jef-sure/esp32-co2-station/images/20260601_181752.jpg

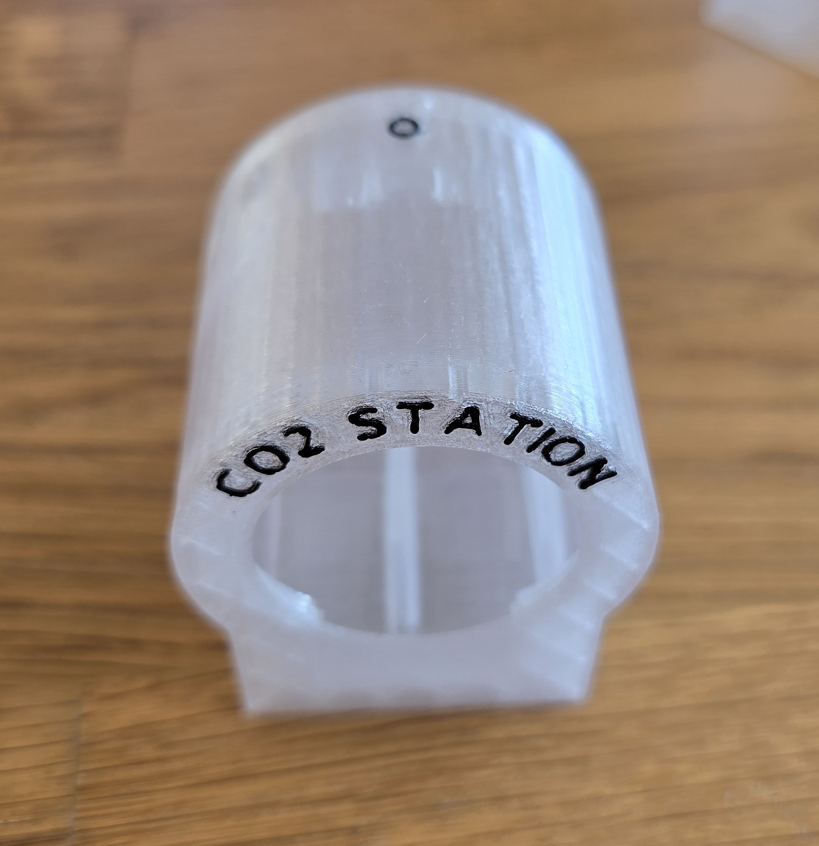
images/20260601_181752.jpg
