jef-sure/esp32-co2-station/images/20260603_193704.jpg

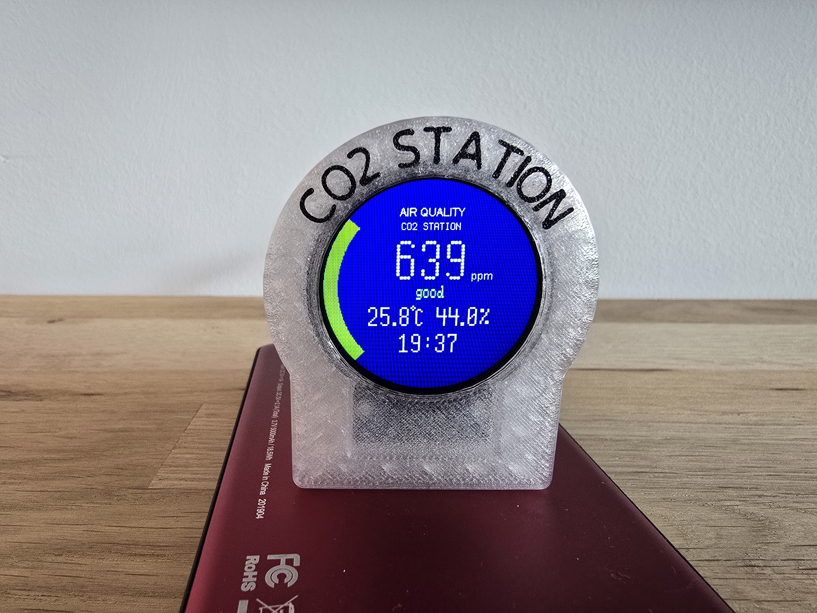
images/20260603_193704.jpg
