jef-sure/esp32-co2-station/images/co2-fihnal-cover-780x440.jpg

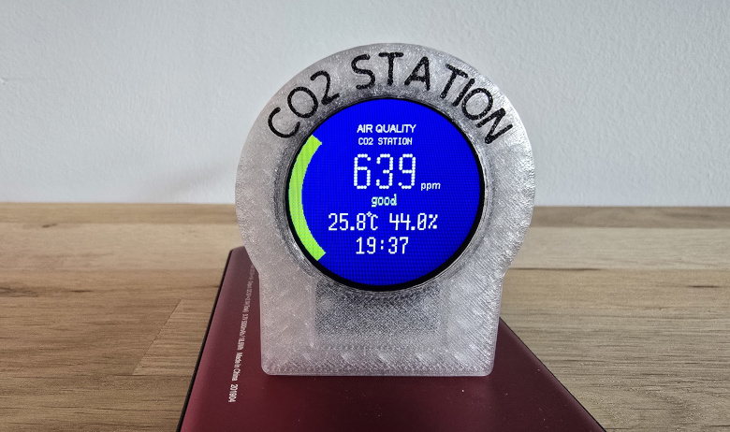
images/co2-fihnal-cover-780x440.jpg
