jef-sure/esp32-co2-station/images/esp32-c3-zero.png

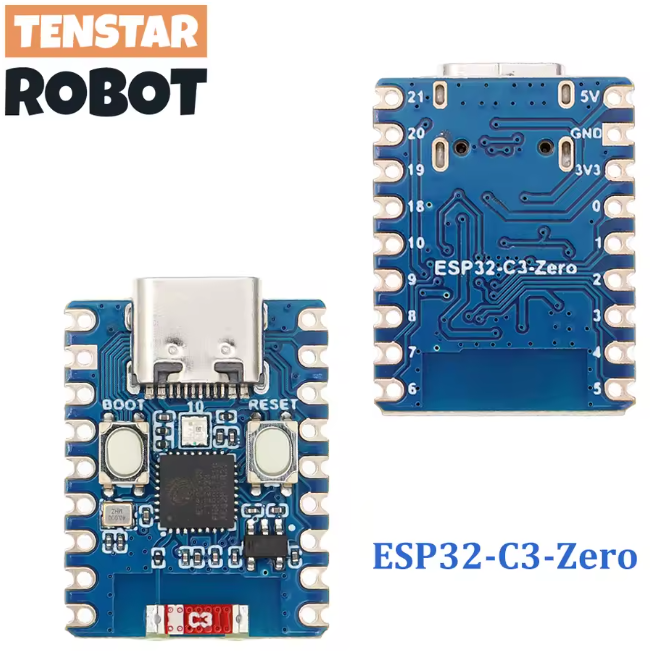
images/esp32-c3-zero.png
