jef-sure/esp32-co2-station/3dModel/round-display-co2-case-clear.3mf

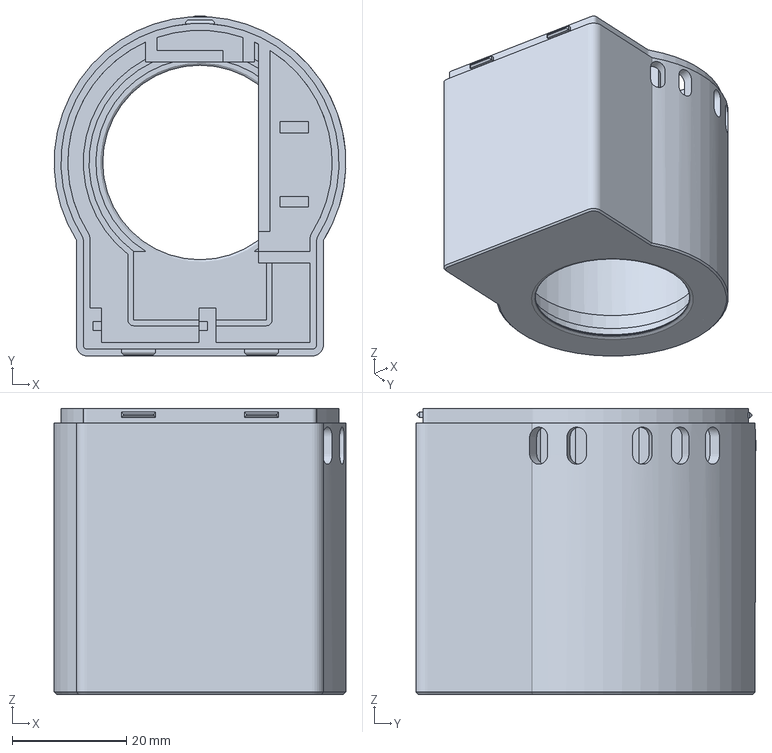
[picture p29: CAD file, 2026-06-01]
3dModel/round-display-co2-case-clear.3mf
51.0 x 59.4 x 50.0 mm
