jef-sure/esp32-co2-station/3dModel/round-display-co2-case-clear-case-round-rear-cap-cut.3mf

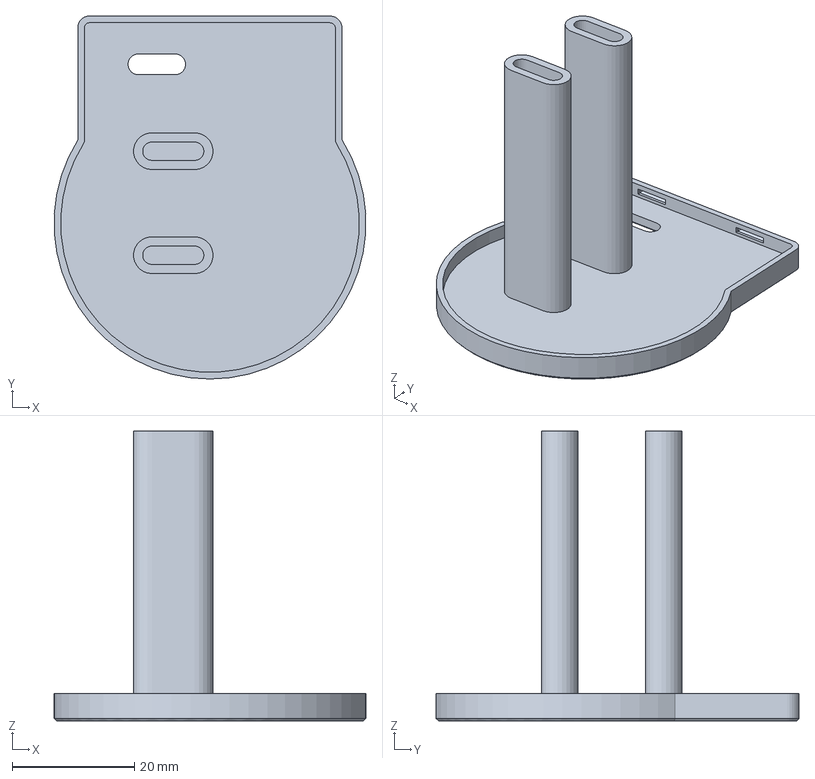
[picture p30: CAD file, 2026-06-01]
3dModel/round-display-co2-case-clear-case-round-rear-cap-cut.3mf
50.9 x 59.3 x 47.4 mm
