jef-sure/esp32-co2-station/main/app_fonts.h

#ifndef CO2STATION_APP_FONTS_H
#define CO2STATION_APP_FONTS_H

#include "dgx_font.h"

dgx_font_t *app_font_dashboard_time(void);
dgx_font_t *app_font_dashboard_title(void);
dgx_font_t *app_font_dashboard_text(void);
dgx_font_t *app_font_dashboard_value_digits(void);
dgx_font_t *app_font_dashboard_value_fallback(void);
dgx_font_t *app_font_dashboard_value_unit(void);
dgx_font_t *app_font_dashboard_subtitle(void);
dgx_font_t *app_font_provisioning_title(void);
dgx_font_t *app_font_provisioning_text(void);

#endif
