jef-sure/esp32-co2-station/(commit log)

2026-06-01 Add provisioning, string manipulation, timezone handling, and HTML templates
    - Introduced `provisioning.h` and `provisioning.c` for Wi-Fi provisioning management.
    - Added `str.h` and `str.c` for enhanced string manipulation functions.
    - Implemented timezone handling with `tzones.h` and `tzones.c`, including functions to find and set timezones.
    - Created Python script `generate_tzones.py` to generate timezone data from system files.
    - Developed HTML templates for CO2Station settings in `index.html` and `index-bs.html`.
    - Added a script `split_to_template.py` to convert HTML templates into C header format.
    - Defined memory partitions in `partitions.csv` for ESP32.
    - Updated `requirements.txt`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
    [partitions.csv]
2026-06-01 Remove redundant details about I²C/SPI pins and display parameters from README
2026-06-01 Add new 3D model files for round display CO2 case
    [round-display-co2-case-clear-case-round-rear-cap-cut.3mf, round-display-co2-case-clear.3mf]
2026-06-02 Update measurement display format for temperature and humidity
2026-06-02 Add power supply information and BOM details to WHATISIT.md
2026-06-03 Refactor README and main.c for improved clarity and formatting
    - Expanded the README to provide a more detailed introduction and project overview.
    - Enhanced the display of device pin assignments in main.c for better readability.
    - Updated the touch button and sensor descriptions to clarify functionality and GPIO usage.
2026-06-04 Add images of ESP32-C3-Zero and CO2 station, fix mqtt when not provisioned
    [main.c]
